Zeke133/MarantzHiFiToHomekit/misc/schematics/schematics.md

# Schematics

## NodeMCU ESP8266 board pinout



## Circuit diagram



[Link to the diargram in CDDX format](circuit.cddx).
Created in https://www.circuit-diagram.org

## Additional hardware connections

1. Power supply board

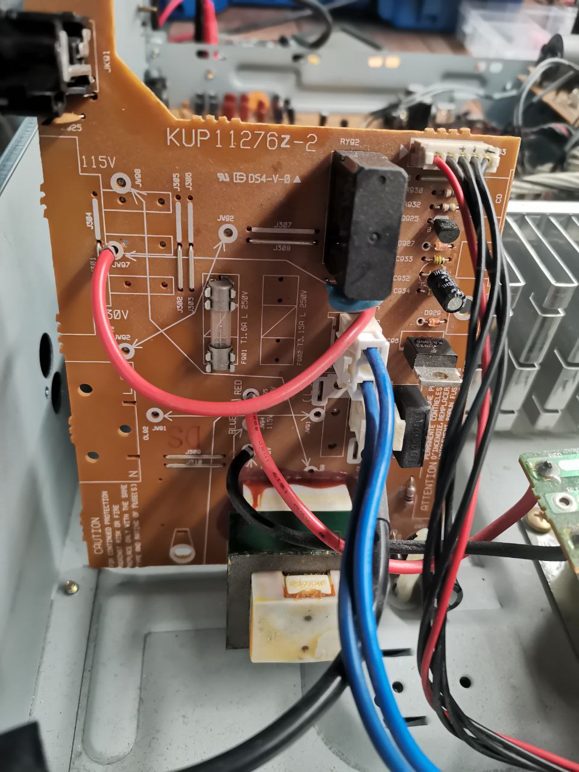
[picture p2: misc/schematics/1.jpg]
Power supply board


2. Power supply board bottom trace

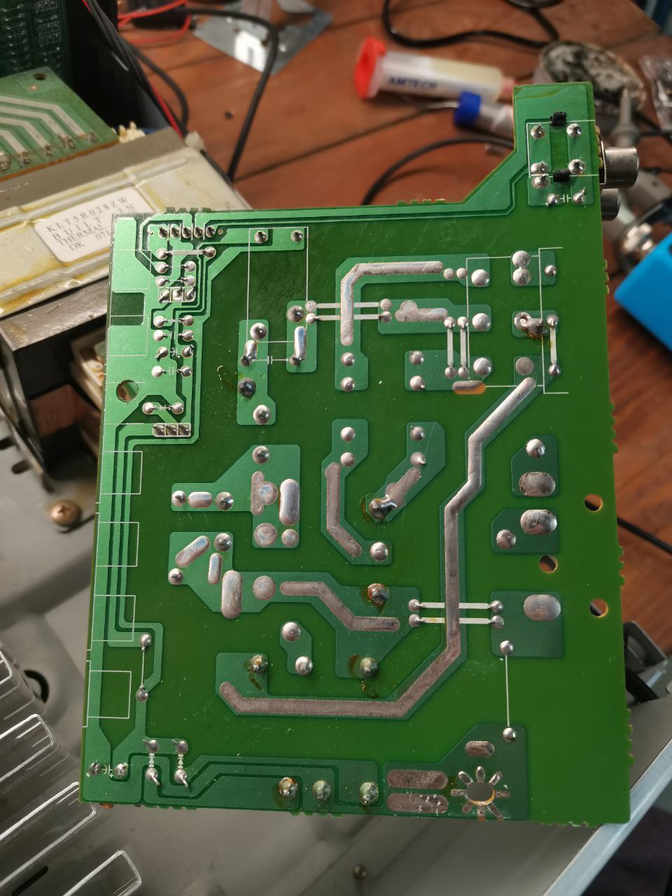
[picture p3: misc/schematics/2.jpg]
Power supply board bottom trace


3. IC power +5V and power relay lines

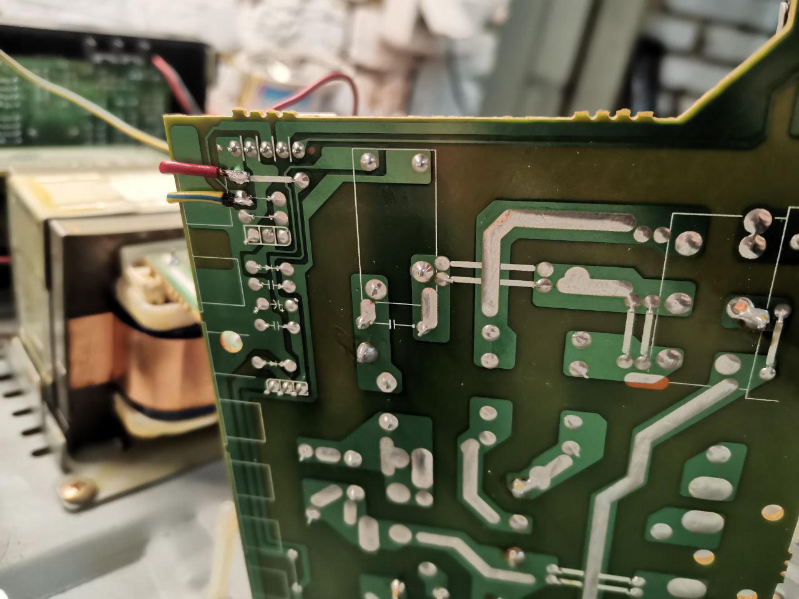
[picture p4: misc/schematics/3.jpg]
IC power +5V and power relay lines


4. Additional 3.5 Jack installed

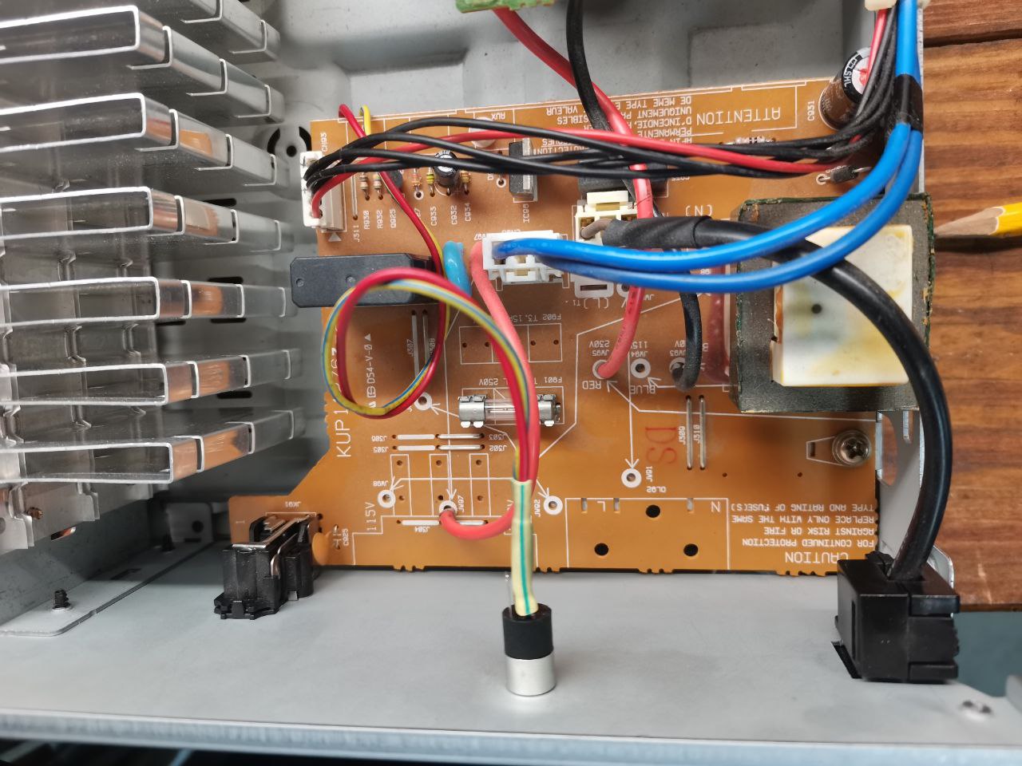
[picture p5: misc/schematics/4.jpg]
Additional 3.5 Jack installed


5. Back side with jack added

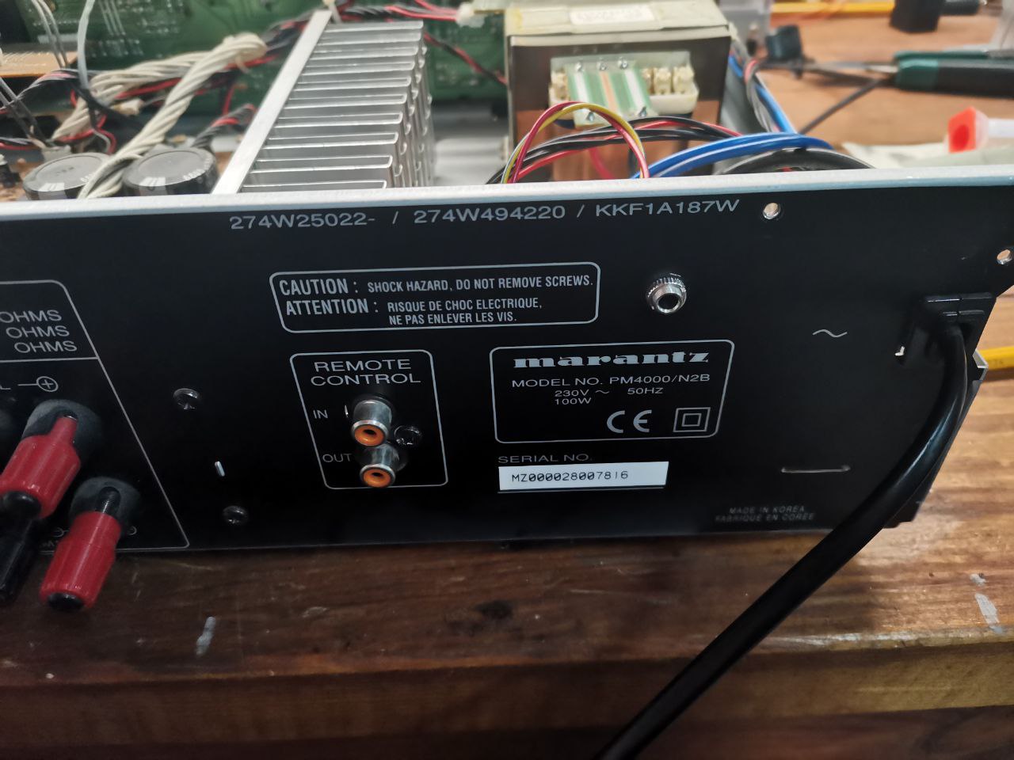
[picture p6: misc/schematics/5.jpg]
Back side with jack added
