Zeke133/MarantzHiFiToHomekit/misc/rc5/rc5.md

## Marantz RC5 IR-remote codes table

[Link to Excel sheet](Marantz%202014%20IR%20Command%20Sheet.xls)

## Here is some examples of how RC5 signals look

### Mute: address - 16, command - 13
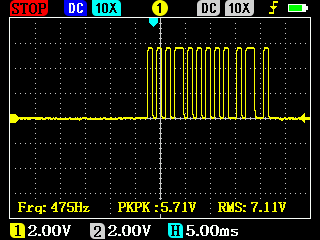
[picture p7: misc/rc5/RC5-16-13.bmp]


### Volume Up: address - 16, command - 16
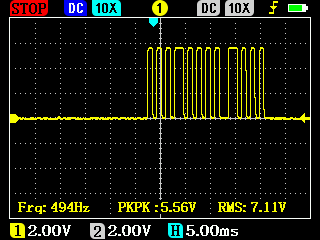
[picture p8: misc/rc5/RC5-16-16.bmp]


### Volume Down: address - 16, command - 17
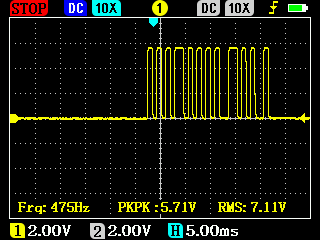
[picture p9: misc/rc5/RC5-16-17.bmp]


### Input tuner: address - 17, command - 63
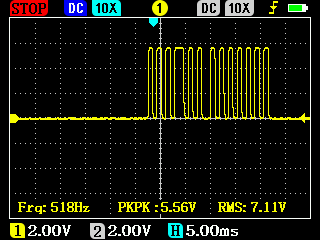
[picture p10: misc/rc5/RC5-17-63.bmp]


### Input tape: address - 18, command - 63
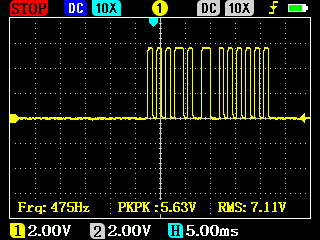
[picture p11: misc/rc5/RC5-18-63.bmp]


### Input CD: address - 20, command - 63. Toggle bit Low!
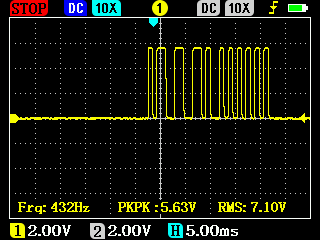
[picture p12: misc/rc5/RC5-20-63-toggle.bmp]


### Input phono: address - 21, command - 63
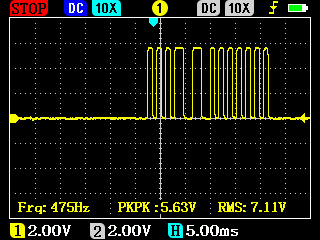
[picture p13: misc/rc5/RC5-21-63.bmp]


### Input CD-R/MD: address - 23, command - 63
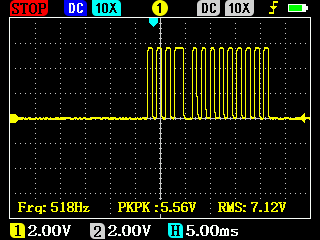
[picture p14: misc/rc5/RC5-23-63.bmp]


### RC5 extended. Shows pause in transmission after address
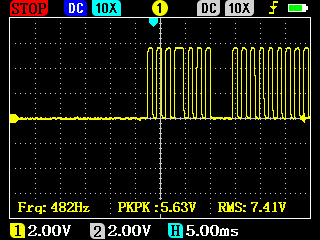
[picture p15: misc/rc5/RC5X-16-xx.bmp]
