Zeke133/MarantzHiFiToHomekit/control-protocol.h

#pragma once

extern int ControlLinePin;

extern void SendMarantzPowerOn();
extern void SendMarantzPowerOff();
extern void SendMarantzInputCD();
extern void SendMarantzInputPhono();
extern void SendMarantzInputTuner();
extern void SendMarantzInputTape();
extern void SendMarantzInputAux();
extern void SendMarantzInputCdrMd();
extern void SendMarantzVolumeUp();
extern void SendMarantzVolumeDown();
extern void SendMarantzMute();
