Zeke133/MarantzHiFiToHomekit/(commit log)

2023-01-29 Initial working version
    [Marantz 2014 IR Command Sheet.xls]
2023-02-10 readme updates
    [Marantz 2014 IR Command Sheet.xls]
